pozdezh/Project_OMEGA_Ph2/evidence/attack_suite.md

# Attack suite: what was tried, and what the system did

Generated by `simlab/attack_report.py` on 2026-08-25 06:12:09.

## How to read this, and what it does not prove

Every attack below runs against a complete copy of the shipped server code, over a real mutual-authentication handshake, inside a throwaway directory with its own certificate authority and its own database. The devices are invented (`AMU_01`, `NMU_01`); no deployed unit, key or measurement is involved, so nothing here can leak an unmeasured number into the project's real data.

**The channel here is DTLS 1.2, not 1.3.** OpenSSL on the development machine predates DTLS 1.3, and wolfSSL has no Windows build. What is proven here is therefore version-independent: mutual authentication, forward secrecy, certificate-bound identity, refusal of an unknown authority, revocation, and detection of an altered record. **DTLS 1.3 itself is proven only on hardware**, where the live server and the ESP32 both report `DTLSv1.3 / TLS_AES_128_GCM_SHA256`.

## Session under test

- **cipher suite**: `ECDHE-ECDSA-AES256-GCM-SHA384`
- **server verified the device**: `True`
- **device verified the server**: `True`
- **identity the server derived**: `AMU_01`

## Summary

| # | Attack | Outcome |
|---|---|---|
| 1 | Eavesdropping on the wire | **defeated** |
| 2 | A genuine device lying about which unit it is | **defeated** |
| 3 | Replaying a captured record | **defeated** |
| 4 | Man in the middle altering a record in flight | **defeated** |
| 5 | A rogue device with a certificate from another authority | **defeated** |
| 6 | A rogue operator calling a device directly | **defeated** |
| 7 | A retired or stolen unit still holding a valid certificate | **defeated** |

**7 of 7 attacks defeated.**

---

## 1. Eavesdropping on the wire

**The attacker has:** a full packet capture of every byte between device and server, and the WLAN password

**What was attempted:** read the sensor values straight out of the captured traffic

**What happened:** The reading is not recoverable. The record is 139 bytes of readable JSON before encryption and 176 bytes on the wire after it, and none of the searched values appear in what was transmitted.

**Evidence**

```
plaintext record  : {"id": "AMU_01", "type": "airq", "ts": 1787631129, "event": "500_1", "hb": false, "sensors": {"scd30": {"co2_ppm": 612.0}}, "cause": "SIM"}
plaintext size    : 139 bytes
ciphertext size   : 176 bytes (+37 overhead)
searched for      : b'co2_ppm', b'612', b'AMU_01', b'airq', b'cause', b'SIM'
found on the wire : NOTHING

first 48 bytes of the ENCRYPTED RECORD as transmitted:
0000  17 fe fd 00 01 00 00 00 00 00 01 00 a3 08 0b 2a  ...............*
0010  74 ea 9d 37 54 49 c4 fd ed 2b 36 94 12 34 f1 f9  t..7TI...+6..4..
0020  5d 72 34 0a 95 b1 a1 c4 55 8b 15 20 27 6a 84 af  ]r4.....U.. 'j..
....  (128 more bytes)
```

---

## 2. A genuine device lying about which unit it is

**The attacker has:** a valid certificate for AMU_01 and its private key

**What was attempted:** send a record claiming `"id": "NMU_99"` so the reading is filed against a different unit

**What happened:** The lie is ignored. Identity is taken from the certificate the device authenticated with, never from the message body.

**Evidence**

```
claimed in the record : NMU_99
certificate presented : AMU_01
stored under          : AMU_01
```

---

## 3. Replaying a captured record

**The attacker has:** a recorded copy of an earlier, perfectly valid record

**What was attempted:** send the identical record again to inflate the readings

**What happened:** The duplicate is absorbed. The database keeps one row per (device, event), so a replay changes nothing.

**Evidence**

```
record sent twice     : event 500_1
rows now in database  : 1
```

---

## 4. Man in the middle altering a record in flight

**The attacker has:** a position on the shared WLAN allowing bytes to be rewritten as they pass

**What was attempted:** flip a single bit in the encrypted record so the server stores a different value than the device sent

**What happened:** The altered record is discarded and never reaches the application. One bit is enough to invalidate the whole record.

**Evidence**

```
bits changed on the wire : 1
bytes in the record      : 179
server accepted it       : NO

first 48 bytes of the altered record:
0000  17 fe fd 00 01 00 00 00 00 00 01 00 a6 8c 52 dd  ..............R.
0010  33 88 2b 03 63 1a 97 d7 cd dc a0 13 4c 87 c7 68  3.+.c.......L..h
0020  34 1e 7b 93 25 45 5e ad d4 c2 36 a3 1c ec 14 9b  4.{.%E^...6.....
....  (131 more bytes)
```

---

## 5. A rogue device with a certificate from another authority

**The attacker has:** the WLAN password, the server's address, and a certificate it issued to itself

**What was attempted:** complete the handshake and start submitting readings

**What happened:** The handshake never completes. The certificate is not signed by this fleet's authority, so the session is refused before any application data can be sent.

**Evidence**

```
handshake result : HandshakeError: server handshake failed, SSL_get_error=1
```

---

## 6. A rogue operator calling a device directly

**The attacker has:** network access to the device and a self-issued operator certificate

**What was attempted:** open the device's live-query channel and command it directly, bypassing the server

**What happened:** The device refuses the caller. A unit authenticates whoever calls it by certificate, exactly as the server does.

**Evidence**

```
handshake result : HandshakeError: server handshake failed, SSL_get_error=1
```

---

## 7. A retired or stolen unit still holding a valid certificate

**The attacker has:** a genuine, unexpired certificate issued by this fleet's own authority, and its private key

**What was attempted:** reconnect after being retired and continue submitting readings

**What happened:** The unit is refused by name. Revocation does not need the certificate to expire or be recalled from the device.

**Evidence**

```
active unit AMU_01  allowed : True
revoked unit AMU_09 allowed : False
```
