pozdezh/Project_OMEGA_Ph2/deploy/esp32/NMU_TEMPLATE/stage3_beta_2_dtls/omega_tasks.h

#ifndef OMEGA_TASKS_H
#define OMEGA_TASKS_H

#include <Arduino.h>

extern TaskHandle_t netTaskHandle;

void tasksInit();
void tasksMarkBootComplete();
void NetworkTask(void* pvParameters);
void SentryTask(void* pvParameters);

#endif  // OMEGA_TASKS_H
