pozdezh/Project_OMEGA_Ph2/amu/test_fixture.ini

[NETWORK]
device_id = AMU_TEST
wifi_ssid = test-ssid
wifi_pass = test-pass
target_port = 11400
server_host =

[SECURITY]
pki_dir = /tmp/omega_test_pki

[TRIGGER_THRESHOLDS]
alarm_heartbeat_interval = 300
co2_critical_high = 1400
co2_critical_clear = 1300
pm_critical_high = 55
pm_critical_clear = 45
temp_critical_high = 30
temp_critical_high_clear = 29
temp_critical_low = 12
temp_critical_low_clear = 13
hum_critical_high = 70
hum_critical_high_clear = 67
hum_critical_low = 25
hum_critical_low_clear = 28
lux_critical_high = 800
lux_critical_high_clear = 750
lux_critical_low = 5
lux_critical_low_clear = 8
co2_delta = 150
pm_delta = 15
temp_step = 1.5
hum_step = 5
lux_step = 100
alarm_sustain_s = 60
alarm_clear_s = 120
min_send_interval_s = 60

[PATHS]
buffer_file = /tmp/omega_test_buffer.json
