pozdezh/Project_OMEGA_Ph2/(commit log)

2026-09-01 Project OMEGA Phase 2: mutual-certificate DTLS 1.3 sensing fleet
    Source, provisioning tools, installers, verification gate and the full
    evidence set for the second-phase final degree project (URV).
    No private keys, no credentials: every key is generated during provisioning
    and stays on the machine that made it. .example templates are committed in
    their place.
    [partitions.csv]
2026-09-01 docs: written for the reader of this repository, not for its author
    Several documents carried framing meant for the author. Rewritten for
    supervisors and anyone replicating the system.
    REPLICATION_AUDIT.md rewritten end to end. A correction found while verifying
    it against the scripts: its operator sequence still told the reader to run
    prepare-amu-card against the golden image, which is clone-amu-card's job.
    prepare-amu-card contains no dd and no losetup and refuses a card Raspberry Pi
    Imager has not written. Both AMU paths are now described separately. Installer
    phases, phase order, pinned library versions and installed tool names were
    re-verified against install_hub.sh.
    A fellow student'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
2026-09-01 Add the user manual, fix five defects that break a fresh install
    The supervisors asked for a document in the style of a user manual, not
    technical, covering what to do to make the whole ecosystem work and which
    files and parameters to touch to change something. Writing it meant auditing
    the installers line by line against the documentation first, which turned up
    five defects that are invisible on a machine configured by hand as the system
    grew, and fatal on a clean one.
    MANUAL.md build the system from an Ubuntu machine, a bare ESP32-S3 board and
    a blank SD card, then run it. All three ways to build an air unit,
    the Raspberry Pi Imager settings including the hostnam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
2026-09-02 docs: switching the daily report to a real endpoint, and what to restart
    CONFIGURATION.md section 7 described a fresh install, where the statistics
    push has no endpoint set and prints instead. A running server is more likely
    to be pointed at the bundled stand-in endpoint (simlab/boss_endpoint_sim.py),
    so the file being edited did not match the instructions. Section 7 now starts
    by reading the file and covers both starting points, and adds:
    - remove OMEGA_STATS_ALLOW_INSECURE=1, which exists only for the local
    simulator and disables the check that refuses a plaintext endpoint;
    - chmod 600 on the cron file, which now holds a bearer token;
    - what the receiving endpoint must accept -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
2026-09-07 Record the versions a rebuild actually depends on
    The version paragraph named wolfSSL and esptool but not the ESP32 Arduino
    core, and folded three separate requirements into one sentence. Two of the
    three decide whether a rebuild reproduces what was measured, so they are
    now listed as requirements rather than buried in prose.
    The one a rebuilder will otherwise hit at runtime: the air unit's inbound
    live-query agent needs CPython 3.11, because the wolfSSL binding mismanages
    thread state on its DTLS server path and CPython 3.12 turns that into a
    fatal error after the first query. install_amu.sh already builds a local
    3.11 for that process, but nothing said so outside the script's comments.
    A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
